fmmr/drimon/README.md

# DriMon — Drivhus Monitor

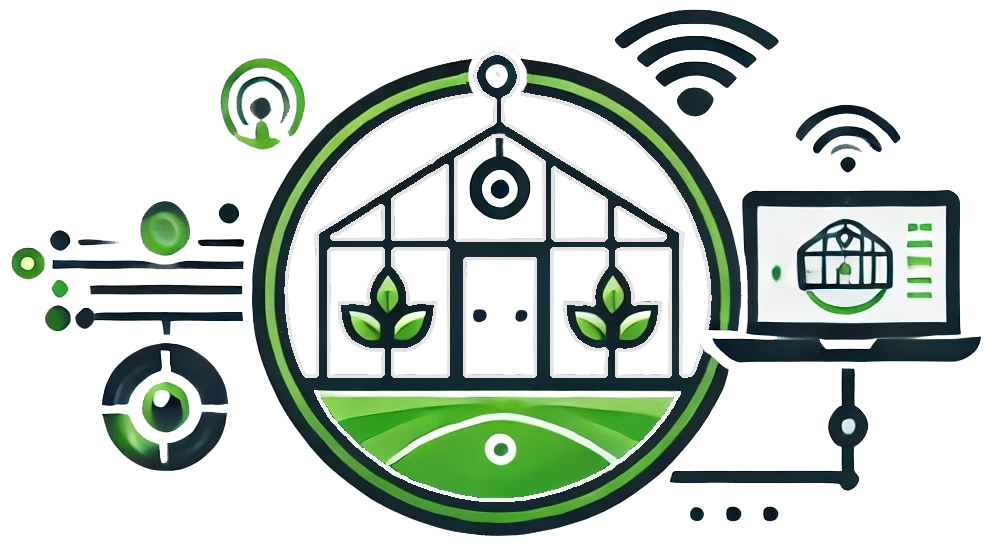
[picture p1: docs/logos/1_1000x550.webp]


Greenhouse monitoring system for Rødtangen, Norway. ESP32 in the greenhouse posts sensor data every 5–15 min to ThingSpeak, a MATLAB scraper adds external weather from MET.no, and a web dashboard renders it all.

**Live site**: <https://drimon.rodland.no/>

## Diagnostics — no serial cable required

The ESP32 sits inaccessible in a greenhouse: no serial monitor, no debugger, no live console. Every runtime signal has to be packed into the ≤255-byte ThingSpeak `status` string that rides on every POST.

**[Status page](https://drimon.rodland.no/status.html)** decodes those strings into a browsable dashboard:

- Per-day range charts for WiFi connect time, measure time, post time, total wake time, battery voltage (min / median / p95 / max)
- Daily WiFi-outcome stack (HIT / FBK / MISS / FAIL) and per-day HTTP-outcome bars per channel
- Distributions over the whole window: WiFi cache-hit rate, per-channel HTTP outcomes with a `FEIL` bucket for silent (all-3-fail) wakes, per-channel retry rescue rate, light/window/temp/battery/pressure class breakdowns, mesh-node BSSID resolution to friendly names
- Recent statuses table with row-click-to-copy raw string, anomaly rows tinted amber, per-channel retry `+1`/`+2` superscripts on HTTP codes
- Top-of-page summary tiles for cold-boot count, silent-post-fail count, retries used, HTTP OK-rate, WT/TU/Post/Total time p50/p95, and more

Full historical post-mortem debugging from any browser — no infrastructure, no logs to rotate, no server-side database. See [QUICK_REFERENCE.md](documentation/QUICK_REFERENCE.md#status-field-decoder) for the exact meaning of each token in the status string.

## Repo layout

| Path | What it is |
|---|---|
| [`20240724_drimon_1_3/`](20240724_drimon_1_3/README.md) | ESP32 firmware (Arduino) |
| [`docs/`](docs/README.md) | Web dashboard (served as GitHub Pages) |
| [`matlab/`](matlab/README.md) | ThingSpeak MATLAB scraper for MET.no weather |
| [`pi-kiosk/`](pi-kiosk/README.md) | Raspberry Pi kiosk that displays the dashboard fullscreen |
| [`documentation/`](documentation/) | Cross-cutting reference docs |
| [`202608_new_setup/`](202608_new_setup/README.md) | Next-revision PCB design workspace (in-progress brainstorm) |
| `sketches_scratchpad/` | Arduino sandbox (ignore) |

## Documentation

Start here depending on what you need:

- **[Quick Reference](documentation/QUICK_REFERENCE.md)** — LED codes, buttons, status field decoder. Print-friendly, stick on the enclosure.
- **[URL Parameters](documentation/URL_PARAMS.md)** — every query-string the live site accepts, with examples.
- **[Architecture](documentation/ARCHITECTURE.md)** — how ESP32 → ThingSpeak → MATLAB → dashboard connect. Data-flow diagram + per-channel field maps.
- **[Hardware](documentation/HARDWARE.md)** — components, sensors, PCB, power budget, Li-Ion voltage table.
- **[Telemetry](documentation/TELEMETRY.md)** — querying and analyzing the ThingSpeak status field (jq/curl pipelines).
- **[Development Guide](documentation/DEVELOPMENT.md)** — webapp architecture and code organization.
- **[Future Enhancements](documentation/FUTURE.md)** — planned and completed items.
- **[Solar Charging Debug](documentation/HARDWARE_SOLAR_CHARGING_CHECK.md)** — historical incident notes.

## ThingSpeak channels

| Channel | Contents |
|---|---|
| [2568299](https://thingspeak.com/channels/2568299) | Main sensors (temp, humidity, RSSI, distance, battery, pressure, lux) |
| [2584548](https://thingspeak.com/channels/2584548) | Plant/soil temperatures + moistures |
| [2584547](https://thingspeak.com/channels/2584547) | System/tech (RSSI, battery, wake time, internal lux) |
| [2626867](https://thingspeak.mathworks.com/channels/2626867) | External weather from MET.no (written by MATLAB scraper) |

## License

Open source under the terms in [LICENSE](LICENSE).
