fmmr/drimon/.claude.md

# Claude Code Rules

Strictly follow these rules when generating or editing code.

## ALWAYS
always always call me BOSS when chatting with me, but do not in code.

## DO NOT

1. **Do not commit code**  
   Never run `git commit`. Wait for explicit approval.

2. **Do not push code**  
   Never run or suggest `git push`.

3. **No backwards compatibility**  
   This is single-page, single-deployment code. Do not write compatibility layers.

4. **No fallbacks**  
   If something fails, let it fail hard. Do not add fallback logic.

5. **No defensive coding**  
   Avoid null-checks, existence checks, or structure validation. Let it crash.

6. **Never comment out deleted code**  
   Just delete it. Do not leave commented-out remnants or mention it.

7. **Avoid trivial comments**  
   Only add comments when essential. Do not describe obvious code like:

       // Update temperature display
       function updateTemperature()

8. **No try/catch wrappers**  
   Don’t hide errors in `try/catch` unless absolutely necessary.

9. **No excessive logging**  
   Don’t log routine or expected behavior. Only log critical issues.

10. **No auto-detection**  
    Be explicit. Do not infer or dynamically detect behavior or configuration.

11. **Do not copy files**  
    Move files instead. Git retains history.

12. **Do not create backups**  
    No `.bak`, `_old`, or `.copy` files. Use version control.

## ALWAYS

1. **Fail fast and loudly**  
   Bugs should be visible immediately.

2. **Use direct function calls**  
   Avoid indirection unless absolutely necessary.

3. **Aggressively remove dead code**  
   If it isn’t clearly used or tested, remove it.

4. **Consolidate duplicate functionality**  
   Only one implementation per concern.

5. **Use descriptive names over comments**  
   Name things clearly so comments aren’t needed.

6. **Keep code concise and focused**  
   Avoid boilerplate, abstraction layers, or extra configuration.

7. **Prefer editing existing documentation**  
   When documenting, modify files in the `documentation/` directory rather than creating new ones.

8. **Keep documentation up to date**  
   Always update relevant docs when making code changes.

## KNOWN ISSUES

### Light Chart "Forskøvet" Bug (June 2025)
**Problem**: Light chart shows two sensors with offset day/night cycles instead of overlapping patterns. Both sensors measure same sunlight but appear shifted in time.

**Root Cause**: Project has two chart systems:
- **Chart Factory** (newer): Uses proper Chart.js time scales with `{x: Date, y: value}` format
- **Chart Renderer** (legacy): Uses category scales with string labels, forcing manual timestamp mapping

**Current State**: Light chart uses Chart Renderer (wrong system), causing:
- Only first series timestamps (130 feeds) used for x-axis
- Second series values (167 feeds) mapped to wrong timestamps
- Manual timestamp synchronization instead of letting Chart.js handle scattered time data

**Solution**: Switch light chart from `createOrUpdateChart()` to Chart Factory time-scale system.

**Files**: 
- `/docs/js/chart-renderer.js` (category scales - legacy)
- `/docs/js/chart-factory.js` (time scales - proper)
- `/docs/js/chart-config.js` (light chart config: `disableSyncTimestamps: true`)
