fmmr/drimon/docs/img/android-chrome-192x192.png

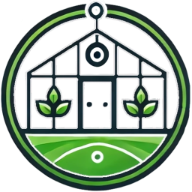
docs/img/android-chrome-192x192.png
