fmmr/drimon/(commit log)

2024-02-14 just some arduino sample code with several sensors and oled text display
2024-02-14 Added comments on wiring
2024-02-14 time printed to serial is total loop time. Added leds for hygro
2024-02-21 Started playing with an esp32. changing the hue of an rgb led with a potmeter
2024-06-05 addeds luxmeter & ultrasonic distance for windows
2024-06-06 added blue led (update to thingspeak)
2024-06-06 averaging multiple reading for data to avoid getting outliers
    [2024_drivhus_oled_wifi_Thingspeak.ino]
2024-06-12 reverted code to pre-double wake-up buttons which didn't work helas
    [2024_drivhus_oled_wifi_Thingspeak.ino, buzzer.ino]
2024-06-13 Added LCD and no timer sleep if NOT in greenhouse (green mode). added sketch with both LCD and 7 segment
2024-06-14 Added BNMP180 pressure sensor
2024-06-15 only 2 readings due to battery consumption. tweaked LCD while debugging battery
2024-07-11 misc code/sensor experiments
2024-07-24 small incremental change to drimon_1_3 (added sensors and measuring
2024-07-24 small incremental change to drimon_1_3 (added sensors and measuring)
2024-07-24 most of the sensors now work
2024-07-24 sleeping seems to work now - too short values though - but committing to have a place to revert to
    [20240724_drimon_1_3.ino, 3_setup.ino, 7_display.ino, 8_sleep.ino, 9_thingspeak.ino]
2024-08-07 added titles on HTML page. Adjusted light-values in code. thingspeak posting also on button push.
2024-08-08 changed titles for battery
2024-08-11 battery > 80 is green
2024-08-11 Added styling for pressure
2024-08-12 added temperature from yr.no on html page
2024-08-15 commented out call to met.no from arduino, but created a trigger in thingspeak to update data in an external channel (2626867). Modified script to have channel-id and chart instead of urls for the if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
2025-04-29 Refine header layout for better space usage\n\n- Converted to single-line layout for desktop view\n- Added yr.no link as a data chip for consistency\n- Moved GitHub link to logo for cleaner appearanc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
2025-04-29 Improve header UI and add Met.no integration
    - Repositioned yr.no weather data chip next to temperature display
    - Updated data chip to show actual temperature from Met.no API
    - Improved date range buttons with better visibility and styling
    - Changed "Oppdater" button color to match the green theme
    - Fixed CORS issues with Met.no API integration
    - Added periodic refresh for weather data
2025-04-29 Fine-tune chart rendering to maximize space usage
    - Reduced container minimum height to 150px for better desktop screen utilization
    - Optimized mobile chart height to 220px with minimal blank space
    - Reduced margins and paddings to maximize chart drawing area
    - Decreased number of axis ticks in mobile view (2 for X-axis, 3 for Y-axis)
    - Reduced font sizes for title and axis labels in mobile view
    - Positioned title and axes closer to edge to maximize chart space
    - Improved overall space efficiency for all screen sizes
2025-04-29 removed a couple of date-links to be nicer on mobile
2025-04-29 Fix pressure classification bug in data.js
2025-04-30 Simplify weather data fetching and remove unused file
    - Remove unused met.js file and its reference in index.html
    - Simplify weather data fetching by combining multiple functions into a single streamlined function
    - Maintain the same functionality with cleaner code structure
    - Improve readability with better flow control
2025-04-30 Migrate to Chart.js implementation with improved mobile support
    - Replace D3.js with Chart.js for improved performance and compatibility
    - Add responsive mobile layout with single-column chart view
    - Implement category-based chart sorting for mobile devices
    - Add direct YR.no weather data fetching with client-side caching
    - Implement ThingSpeak fallback for browsers with CORS restrictions
    - Optimize chart loading with parallel data fetching
    - Update UI with modern responsive design
    - Add enhanced mobile navigation
2025-04-30 Add 'yr:' prefix to the met/yr temperature pill
2025-04-30 Implement dynamic temperature and battery icons based on their values
2025-04-30 Add min/max/avg statistics display to charts and optimize tick rendering
    - Add min/max/average statistics to each chart (toggleable via UI)
    - Set Vindusåpning chart minimum value to 50mm using configuration
    - Optimize X-axis tick count based on chart size (4 ticks for small charts, 6 for larger)
    - Use 6 ticks on mobile view for better readability
    - Refactor chart layout logic to remove redundant configuration
2025-04-30 Add statistics toggle button and display styling
    - Add toggle button to show/hide min/max/average statistics
    - Store statistics display preference in localStorage
    - Add styling for statistics in both light and dark mode
    - Optimize positioning on mobile view
2025-04-30 Fix weather icon display in Safari
    - Use browser detection to provide different icon rendering based on browser
    - Use Font Awesome icons for Safari instead of SVG files
    - Add fallback icon logic for ThingSpeak data which has no symbol code
    - Provide temperature-based icon selection for fallback
2025-04-30 Implement proxy solution for Met.no API in Safari
    - Apply recommendation from Met.no API documentation to use a proxy
    - Try CORS proxy first to ensure Safari compatibility
    - Fall back to direct API for browsers that support it
    - Use ThingSpeak only as a last resort
    - Improve logging to track request success/failure
2025-04-30 Enhance chart stats: add current value and improve readability
2025-04-30 Add support for multi-series charts including combined cucumber and padron temperature chart
2025-04-30 Remove columnSpan property and reposition the plant temperature chart; fix legend display
2025-04-30 Create separate category for plant temperatures and use distinct red colors
2025-04-30 Add multi-series chart for BME and AHT temperature sensors
2025-04-30 Add Gulv Temp as third data series in sensor temperatures chart
2025-04-30 Add second y-axis support for light chart and update labels
2025-04-30 Fix scaling for dual y-axis to use proper values from datasets
2025-04-30 Fix dual y-axis by ensuring axis configuration is properly passed to Chart.js
2025-04-30 Update multi-series temperature chart colors for better distinction
2025-04-30 Multiple UI improvements: hide current value for multi-series charts, update colors, reduce label size
2025-04-30 Add multiple enhancements: add current values to multi-series chart titles, fix disappearing charts, update soil moisture colors
2025-04-30 1. Updated the chart_renderer.js to use the chart legend instead of updating the chart titles for displaying current values 2. Modified the refresh logic in script.js to rely on chart updates through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
2025-05-01 Improve text readability in dark mode and update chart legends
    1. Enhance stats display with higher contrast text colors and better typography:
    - Change color from #777 to #c0c0c0 for better visibility
    - Add subtle text shadow to improve readability
    - Remove underlines under stats values
    - Highlight current values with distinct colors (#d5ffd5 in dark mode)
    2. Improve multi-series chart legends:
    - Replace color boxes with thin horizontal lines
    - Increase contrast in dark mode
    - Adjust font weight and spacing for better readability
    - Ensure consistent styling across Chart.js versions
    3. Update FUTURE.md with completed features and new enhancement ideas
    🤖 Generate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
2025-05-01 Fix header control functionality
    - Fixed date pill event handlers not working with dynamic header
    - Fixed dark mode toggle functionality
    - Fixed chart stats toggle
    - Centralized event handler attachment in index.html
    - Removed duplicate event handler setup from script.js and chart_renderer.js
2025-05-01 Update FUTURE.md with completed tasks and new enhancement ideas
    - Updated completed tasks section to reflect recent code improvements
    - Added details about component architecture and test mode
    - Added four new enhancement categories:
    - Accessibility Improvements
    - Multi-Device Synchronization
    - Performance Optimizations
    - Internationalization and Localization
    - Added new feature ideas to existing categories
2025-05-02 Add internationalization and configurable chart statistics
    This update brings two major enhancements to the DriMon dashboard:
    1. Comprehensive Internationalization (i18n)
    - Added support for Norwegian, English, and Spanish
    - Implemented language switcher in the header
    - Created centralized translation system for all UI elements
    - Added automated i18n testing framework
    2. Configurable Chart Statistics
    - Added horizontal lines showing average values on all charts
    - Implemented configurable min/max indicators
    - Added specific indicator configurations for temperature, humidity,
    battery, window, and WiFi charts
    - Optimized performance by limiting the number of indic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
2025-05-03 Fix chart statistics calculation and remove debug logs
    - Fixed minimum value calculation to properly filter out statistical datasets
    - Added chart stats recalculation function to ensure stats are updated after chart data changes
    - Implemented robust filtering of non-data datasets like average lines and min/max points
    - Removed debug console logs
2025-05-04 Implement core utilities and testing framework for refactoring
    This commit sets up the foundation for the DriMon web interface refactoring:
    - Add core utilities module (utils.js) with comprehensive helper functions
    - Create testing framework with robust assertions and interactive tests
    - Implement documentation for code analysis, dependencies, and module interfaces
    - Add testing guidelines emphasizing direct imports and real data usage
    - Enhance test.html with interactive test sections for all utility functions
    - Update refactoring plan with completed items and next steps
2025-05-06 Improve chart rendering and mobile sorting
    - Fix mobile chart sorting functionality by addressing timing issues
    - Replace hard-coded conditionals with configuration-driven approach
    - Add structured formatting configuration with useIntegerFormat and decimalPlaces
    - Add robust Y-axis configuration capabilities
    - Add structured indicator configuration
    - Remove mobile sorting hint from UI
    - Fix decimal formatting in tooltips for Light and Pressure charts
    - Add fallbacks for missing chart elements to improve robustness
2025-05-06 Implement configuration-driven chart value transformation and formatting
    - Add dataTransform configuration property to window chart with shiftBy: -57
    - Implement data transformation in chart_renderer.js and data_components.js
    - Apply normalization to window opening chart (57mm → 0mm)
    - Fix Y-axis tick formatting to display integers without decimal places
    - Add consistent integer formatting for window chart statistics
    - Update tooltip handling to support transformed values
    - Enhance chart i18n system for better label translation
    - Add documentation for data transformation options
2025-05-06 Update REFACTORING_PLAN.md to reflect completed tasks
    - Mark completed tasks throughout the refactoring plan
    - Update next steps section to reflect current progress
    - Add data transformation system to completed chart configuration tasks
    - Update internationalization improvements status
    - Mark chart renderer and data components tasks as completed
    - Note completed responsive design and optimization tasks
2025-05-06 Comprehensive i18n system refactoring
    This commit consolidates all internationalization (i18n) functionality in the DriMon application:
    1. Single Source of Truth for Translations
    - Removed legacy translations.js file entirely
    - Eliminated duplicate translations.json file
    - Consolidated all translations into translations-loader.js
    - Fixed Norwegian typos in translation strings (\Plantetemperaturer\, \Sensortemperaturer\)
    2. Modernized i18n System Architecture
    - Added backward compatibility layer to handle legacy code
    - Rewrote chart-i18n.js to eliminate language-specific text
    - Created dynamic translation key inference to support legacy code
    - Implemented improved error handling for missing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
2025-05-06 fixed bugs in mobile view and chart x-axis ticks
2025-05-07 refactor: Modularize chart system and fix UI issues
    - Extract layout and statistics into dedicated modules
    - Remove backward-compatibility code and fallbacks
    - Fix legend flickering during language switching
    - Fix tooltip date formatting and cross-chart sync
    - Add smart date format based on timespan
2025-05-07 refactor: Modernize chart system and remove test files
    - Extract chart internationalization logic into chart-i18n.js module
    - Move tooltip synchronization to chart-utils.js
    - Simplify code by delegating to specialized modules
    - Remove all test files and references to them
    - Update documentation to focus on manual testing
    - Fix UI issues including legend flickering during language switching
    - Improve tooltip synchronization between charts
    - Enhance date formatting in tooltips
2025-05-07 feat: Implement chart-specific default time ranges
    Add a new default date range option (⌂) that uses chart-specific default ranges:
    - Add defaultRange property to chart configurations (1d for temperature, 13d for pressure, 6d for battery, 30d for WiFi)
    - Add house icon (⌂) for default date option in all translations
    - Fix date picker click handling to properly update charts
    - Default to house icon when no range parameter is provided in URL
    - Update documentation with detailed explanation of default range feature
2025-05-08 feat: Add astronomical data chip with sun & moon information
    - Display moon phase as SVG with proper language support
    - Show next sunrise/sunset time in 24h format
    - Display time remaining until next solar event
    - Add comprehensive tooltip with lunar and solar information
    - Include day and night length calculations
    - Ensure proper translations in Norwegian, English, and Spanish
    - Use language-specific time format (t for timer in Norwegian, h in English/Spanish)
    - Add SunCalc library for astronomical calculations
2025-05-09 feat: Implement mobile-friendly tooltips for key data chips
    - Create custom tooltip system that works on both desktop and mobile devices
    - Add tooltip-controller.js to handle tooltip functionality with mobile support
    - Add tooltip.css for consistent tooltip styling
    - Update data chips to use custom tooltips only for specific chips (temperature, window, light, weather, sun)
    - Restore proper data display in tooltips for windows, light, and weather
    - Fix styling to show indicator dots on chips with tooltips
    - Add mobile-friendly touch interaction that auto-closes after 5 seconds
2025-05-09 twekaed a couple of tooltips
2025-05-09 fix: Add missing 'statsLoading' translations
    - Added Norwegian translation: "Laster statistikk..."
    - Added English translation: "Loading statistics..."
    - Added Spanish translation: "Cargando estadísticas..."
    This fixes the missing translation warning in the temperature tooltip.
2025-05-09 feat: Implement CSS-based tabular formatting for tooltips
    - Add CSS classes for proper tooltip table layout (tooltip-table, tooltip-row, tooltip-label, tooltip-value)
    - Add visual divider support for separating tooltip sections
    - Update formatTabularTooltip utility to generate HTML tooltips
    - Update tooltip controller to handle HTML content
    - Implement tabular formatting for all data-chip tooltips (weather, sun, temperature, light, battery, window)
2025-05-09 feat: Add sun and moon position information to tooltip
    - Add current sun and moon position to the sun-events tooltip
    - Show compass direction (N, NE, E, etc.) and height (degrees) for both
    - Add utility function to convert azimuth to compass direction
    - Update translations for all supported languages
    - Mark celestial bodies as 'not visible' when below horizon
    - Organize tooltip with sun information in first section and moon in second
2025-05-09 feat: Add visible planet positions to astronomical tooltip
    - Create new module for simplified planetary position calculations
    - Add positions for Mercury, Venus, Mars, Jupiter, and Saturn
    - Show compass direction and height for visible planets
    - Organize tooltip into three sections (sun, moon, planets)
    - Add multilingual support for planet names
    - Show only planets that are currently above the horizon
    - Update tooltip formatting utility to support multiple dividers
2025-05-12 Add weather forecast tooltip
    - Create constants.js with shared location coordinates
    - Add forecast.js to fetch and display multi-day weather forecast
    - Show current weather conditions and 7-day forecast in tooltip
    - Organize forecast by day and time period (night, morning, afternoon, evening)
    - Update tooltip handling to support forecast tooltip
2025-05-13 Add current values to all multi-series chart legends
    - Enable consistentLegendLabels option for all multi-series charts
    - Uses existing legend value formatting from chart-i18n.js
    - Shows current values in the legend for each data series
    - Applied to light chart, plants and sensors temperature charts
2025-05-13 Improve chart statistics display with intuitive symbols
    - Replace single-letter labels (L,A,H,N) with Unicode symbols (▼,●,▲,◆)
    - Add title attribute to show full label name on hover
    - Increase desktop font size to 11px for better readability
    - Set mobile font size to 13px for balanced display
    - Match text and symbol sizes for visual consistency
    - Use color-coded symbols to make stats more intuitive at a glance
    - Add dark mode support with brighter symbols
2025-06-17 bug in y-range for voltage
2025-06-20 fixed data filtering for bad values
2025-06-20 x-axis tick values
2025-06-22 fixed x-axis for default
2025-06-27 Added pi-kiosk files to put the dashboard on to a raspberry pi in kiosk mode.
2025-07-11 tweaked icon, colour and added the name of the current water level
2025-07-11 cooler air-pressure-level icons.
2026-07-20 Added some fixes for erronous temp-readings
    [5_measure.ino]
2026-07-23 single-chart URL view, hidden charts, 85 filter on floor/padron
2026-07-25 merged battery chart (v + %), added UV chart, per-series units, DS18B20 range filter
2026-08-04 added heat-frost + status subpages. shared subpage-footer. WiFi fail-streak counter (FC-) in firmware
    [3_setup.ino, 5_measure.ino, 9_thingspeak.ino]
2026-08-04 twekaing temperatures
2026-08-05 add BS/BV/TU status tokens + per-channel LED sequence + cache-invalidate on fail streak. status page: 3-channel merge with partial-post tracking, battery + BSSID + FC charts, whitelist-only parser. a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
    [20240724_drimon_1_3.ino, 3_setup.ino, 5_measure.ino, 9_thingspeak.ino]
2026-08-05 firmware: extract magic numbers to commented #defines (WiFi timing/static-IP, sensor plausibility bounds, Dallas retries, TOF limits, serial baud). flashLED refactored to take separate on/off duratio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
2026-08-05 commit version.h as skip-worktree template
    [version.h]
2026-08-05 firmware: NTP-every-wake for accurate snap, sleep-to-round-minute w/ 30 s buffer + off-season 3× multiplier, add PF/LR/V tokens (git hash via gen_version.sh + post-commit hook), client.stop between c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
    [20240724_drimon_1_3.ino, 3_setup.ino, 8_sleep.ino]
2026-08-05 firmware: recalibrate light thresholds (DUSK 500→1500, SHADE 12000→25000) from observed lux data, add TV/LX/WD raw-value status tokens (aggregate temp, ceiling lux, window mm). status page: raw value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
    [20240724_drimon_1_3.ino, 5_measure.ino]
2026-08-06 added small installer for arduino pre-build hook
2026-08-06 added support for arduino-cli
2026-08-06 status page: per-channel HTTP distribution boxes (Ch1/Ch2/Ch3) with FEIL bucket for silent (PF) wakes, LT/LP daily histograms + p95 marker on all range bars, distTile helper for timing tiles (p50/p95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
2026-08-07 added 202608_new_setup for designing a new PCB and setup
2026-08-09 added note on new design: display power
2026-08-10 firmware: mitigate postThingSpeak panic loops
    Panics started 2026-08-07 (day after e1f0d73 retry refactor). Long POST
    cycles with heavy retries crash somewhere in lwIP/WiFiClient; RTC wipes;
    next wake re-enters post and re-panics - 25k+ loop over 11 h, ~130 mAh
    burnt on Aug 8/9 and Aug 9/10 nights.
    Four defenses stacked:
    - fresh WiFiClient per attempt inside postChannel (no lwIP PCB reuse
    across the retry cycle - suspected root trigger)
    - MAX_POST_RETRY 2 → 1 (worst-case post cycle 40 s → 25 s, halves
    retry blast radius)
    - P1/P2/P3/PA breadcrumbs around each channel post so next incident's
    LS token pins down which channel dies
    - circuit breaker: on bad res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
    [20240724_drimon_1_3.ino, 9_thingspeak.ino]
2026-08-10 firmware: unify wake-exit in enterDeepSleep (follow-up to 421b3e0)
    CB early-exit and end-of-setup both open-coded the same "compute sleep
    + stage + arm wake + sleep" sequence. Fold into one function, single
    exit point from setup().
    enterDeepSleep(long start, const char* finalStage, float lux)
    Call sites:
    CB: enterDeepSleep(start, "CB", CB_LUX);
    Normal: enterDeepSleep(start, "OK", data.lux);
    No behavior change on the happy path.
2026-08-10 firmware: CB fires on any bad reset, not just P* (follow-up to 421b3e0)
    [20240724_drimon_1_3.ino]
2026-08-12 scripts: add panics_per_day, battery_history, wake_details for status analysis
2026-08-12 webapp: status page presets - add ← dashboard link, tighter labels
2026-08-12 new-pcb: mandate zero hand-soldered inter-module wires (2026-08-12 recurrence)
2026-08-12 new-pcb: add Power debuggability section - test points, per-rail LEDs, isolation Rs, telemetry tokens
2026-08-13 new-pcb: correct wording - new BAT joint failure, not a recurrence of the documented solar-side one
2026-08-13 new-pcb: add CHG_DISC MOSFET for bias-free battery EMF sampling (BVR token)
2026-08-14 new-pcb: soften Aisler/2-layer/KiCad from requirements to defaults with alternatives noted
2026-08-14 new-pcb: capture enclosure requirements (A1) + refresh resume prompt with session context
2026-08-17 new-pcb: add LoRa/Meshtastic uplink direction (A8) + Heltec V3 coverage-test hardware
2026-08-19 new-pcb: A8 - add power numbers per architecture + explicit decisions checklist. added part-list
2026-08-19 webapp: tighten header icon spacing to avoid unnecessary horizontal scroll. status presets - kun 200 → kun 20 (default n is now 150)
2026-09-21 rename-fields: align guard with CHANGE_ME placeholder
    Guard was still checking for PASTE_HERE after the placeholder text
    was switched to CHANGE_ME, so it stopped catching an unedited script.
2026-10-05 docs: note winter dormancy + refresh BSSID observed-in-production
    FUTURE.md gains a status one-liner at the top: on 2026-10-04 the
    greenhouse was shut down for the winter (windows closed, plants
    removed, watering off); ESP32 + sensors continue only for observation.
    MESH_NODES.md: the "Only SOV_MF has been observed" line was stale —
    STUE has been the normal associator for a while, and SOV_MF took over
    on 2026-10-04 when STUE lost power for ~4h and the mesh re-routed.
